faizanmir21/Rocket-League-Robot/README.md

# Rocket-League-Robot
Final Project for Mechatronics course
Autonomous Soccer Robot

Raspberry pi was used to process all the data from the pixy2 and IMU6050 sensor.

Arduino was used to control the motors and parse location data from pixy, recieve robot and ball coordinates from RFM69 module and send to Raspberry pi for processing.
